Trytka112/Przetwornica_AP63300_SPACE/FAB/PCB_Space_BOM.csv

# | Reference | Qty | Value | Footprint | MPN | MANUFACTURER | LSCS Part
1 | C1 | 1 | 10u | Capacitor_SMD:C_1206_3216Metric_Pad1.33x1.80mm_HandSolder | CL31B106KBHNNNE | Samsung Electro-Mechanics | C89632
2 | C2,C3 | 2 | 22u | Capacitor_SMD:C_1206_3216Metric_Pad1.33x1.80mm_HandSolder | HGC1206R7226K160NSPJ | Chinocera | C7472972
3 | C4 | 1 | 100n | Capacitor_SMD:C_0603_1608Metric_Pad1.08x0.95mm_HandSolder | CC0603KRX7R7BB104 | YAGEO | C108079
4 | C5 | 1 | 47p | Capacitor_SMD:C_0603_1608Metric_Pad1.08x0.95mm_HandSolder | CC0603JRNPO9BN470 | YAGEO | C105622
5 | J1 | 1 | Conn_01x03_Pin | Connector_PinHeader_2.54mm:PinHeader_1x03_P2.54mm_Vertical | DZ127R-11-03-20 | DEALON | C47278490
6 | L1 | 1 | 6u8 | Inductor_SMD:L_Coilcraft_XAL7030-682 | BMQA000606306R8MA1 | Chilisin Elec | C6752824
7 | R1 | 1 | 158k | Resistor_SMD:R_0603_1608Metric_Pad0.98x0.95mm_HandSolder | RS-03K1583FT | FH (Guangdong Fenghua Advanced Tech) | C321734
8 | R2 | 1 | 30k1 | Resistor_SMD:R_0603_1608Metric_Pad0.98x0.95mm_HandSolder | RC0603FR-0730K1L | YAGEO | C137745
9 | U1 | 1 | AP63300WU-7 | Footprint szrot:SOT95P280X100-6N | AP63300WU-7 | DIODES | C2158012
