Trytka112/Przetwornica_AP63300_SPACE/KiCAD/PCB Space.kicad_pcb

## KiCad design KiCAD/PCB Space.kicad_pcb (2026-10-27)

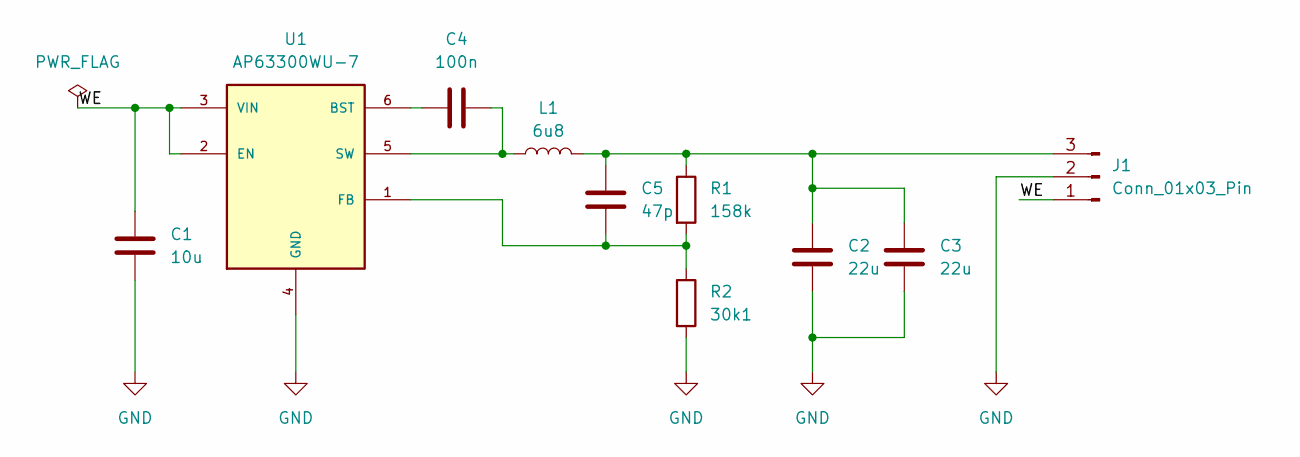
[picture p4: schematic PCB Space.kicad_sch, Schemat_Przetwornica_space_rekrutacja]

Parts:
C1: 10u; C_1206_3216Metric_Pad1.33x1.80mm_HandSolder
C2, C3: 22u; C_1206_3216Metric_Pad1.33x1.80mm_HandSolder
C4: 100n; C_0603_1608Metric_Pad1.08x0.95mm_HandSolder
C5: 47p; C_0603_1608Metric_Pad1.08x0.95mm_HandSolder
J1: Conn_01x03_Pin; PinHeader_1x03_P2.54mm_Vertical
L1: 6u8; L_Coilcraft_XAL7030-682
R1: 158k; R_0603_1608Metric_Pad0.98x0.95mm_HandSolder
R2: 30k1; R_0603_1608Metric_Pad0.98x0.95mm_HandSolder
U1: AP63300WU-7; SOT95P280X100-6N; PARTREV 2020-04-24

Connections:
/WE: C1.1, J1.1, U1.2 (EN), U1.3 (VIN)
GND: C1.2, C2.2, C3.2, J1.2, R2.2, U1.4 (GND)
unnamed: C2.1, C3.1, C5.1, J1.3, L1.2, R1.1
unnamed: C4.1, U1.6 (BST)
unnamed: C5.2, R1.2, R2.1, U1.1 (FB)
unnamed: C4.2, L1.1, U1.5 (SW)

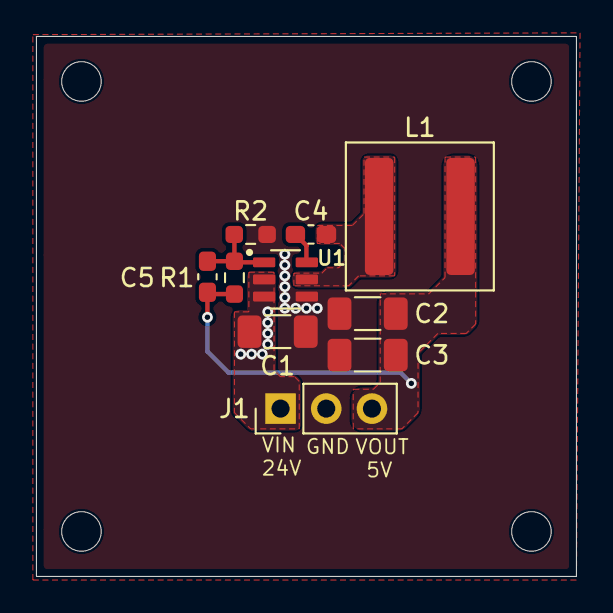
[picture p5: board PCB Space.kicad_pcb from above]

Board: 2 copper layers, 30.0 x 30.0 mm, 10 parts (0 on the bottom side), 6 nets.
