Trytka112/Przetwornica_AP63300_SPACE/(commit log)

2026-10-27 Add FAB/PCB_Space_BOM.csv file
    [PCB_Space_BOM.csv]
2026-10-27 Poprawki + opis
    [PCB Space.kicad_pcb, PCB Space.kicad_sch]
